fkummer/Electrical-and-Software/README.md

# Electrical-and-Software
Repository for the 2016-2017 Electrical and Software subteam of CRT

We're using the GitFlow Workflow! SO DON'T COMMIT TO MASTER!!!!! Make pull requests into develop.

Learn more about GitFlow here: https://www.atlassian.com/git/tutorials/comparing-workflows/gitflow-workflow
