fkummer/Electrical-and-Software/RCS/INTEVLoggerParts.txt

1. 3.3V Regulator http://www.mouser.com/ProductDetail/STMicroelectronics/LD1117S33TR/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
