fkummer/Electrical-and-Software/RCS/INTEVLogger Bill of Materials.xlsx

RCSMCU
Part Name | Value | Quantity | Datasheet | Supplier | Notes
Female micro-usb |  | 1 |  | https://www.sparkfun.com/products/8533
ATmega328p | ucontroller | 1 |  | http://www.digikey.com/product-detail/en/atmel/ATMEGA328P-AUR/ATMEGA328P-AURCT-ND/3789455
FT232RL | FTDI | 1 |  | http://www.digikey.com/product-detail/en/ftdi-future-technology-devices-international-ltd/FT232RL-REEL/768-1007-1-ND/1836402
Crystal | 8MHz | 1 |  | https://www.sparkfun.com/products/538
LED | GREEN | 1 |  | http://www.digikey.com/product-detail/en/kingbright/APTL3216CGCK/754-1162-1-ND/1747879
LED | YELLOW | 2 |  | http://www.digikey.com/product-detail/en/lite-on-inc/LTST-C150AKT/160-1166-1-ND/269238
LED | RED | 1 |  | http://www.digikey.com/product-detail/en/kingbright/APTL3216SURCK/754-1165-1-ND/1747882
Resistors | 10k | 3 |  | http://www.digikey.com/product-detail/en/yageo/RC1206JR-0710KL/311-10KERCT-ND/732156
Resistors | 100 | 4 |  | http://www.digikey.com/product-detail/en/yageo/RC1206FR-07100RL/311-100FRCT-ND/731438
Capacitors | 10uf | 1 |  | http://www.mouser.com/ProductDetail/Murata/GRM31CR61E106KA12K/?qs=giATsht9l5y2a9ASvPbnVA%3D%3D
Capacitors | 0.1uf | 6 |  | http://www.mouser.com/ProductDetail/AVX/12065C104KAT2A/?qs=WcAEtQi8OAaNkVk1OXh0eQ%3D%3D
Capacitors | 22pf | 2 |  | http://www.mouser.com/ProductDetail/Murata/GRM31A7U2J220JW31D/?qs=BT0JzrMzk1UKv3wBPModOw%3D%3D
MPU-9250 | IMU | 1 |  | http://www.digikey.com/product-detail/en/invensense/MPU-9250/1428-1019-1-ND/4626450?WT.srch=1
MPL3115a2 Altimeter | Altimeter | 1 |  | http://www.digikey.com/product-detail/en/nxp-usa-inc/MPL3115A2/MPL3115A2-ND/2817529
Micro SD connector |  | 1 |  | https://www.adafruit.com/products/1660?gclid=CKetvaHWx9ECFZCFswodQrwH7A
3.3V Regulator |  | 1 |  | http://www.mouser.com/ProductDetail/STMicroelectronics/LD1117S33TR/
SMD Switch |  | 1 |  | http://www.mouser.com/ProductDetail/ALPS/SKPMANE010/?qs=m0BA540hBPdOXU%252bNv5vyYw%3D%3D
Battery |  | 1 |  | https://www.adafruit.com/products/1578
JST Header | 2 port | 1 |  | https://www.adafruit.com/product/1769
SD Card | 16 GB | 1 |  | https://www.sparkfun.com/products/13833
