fkummer/Electrical-and-Software/Subscale/Schematics/documentation-sen0142/Layout.pdf

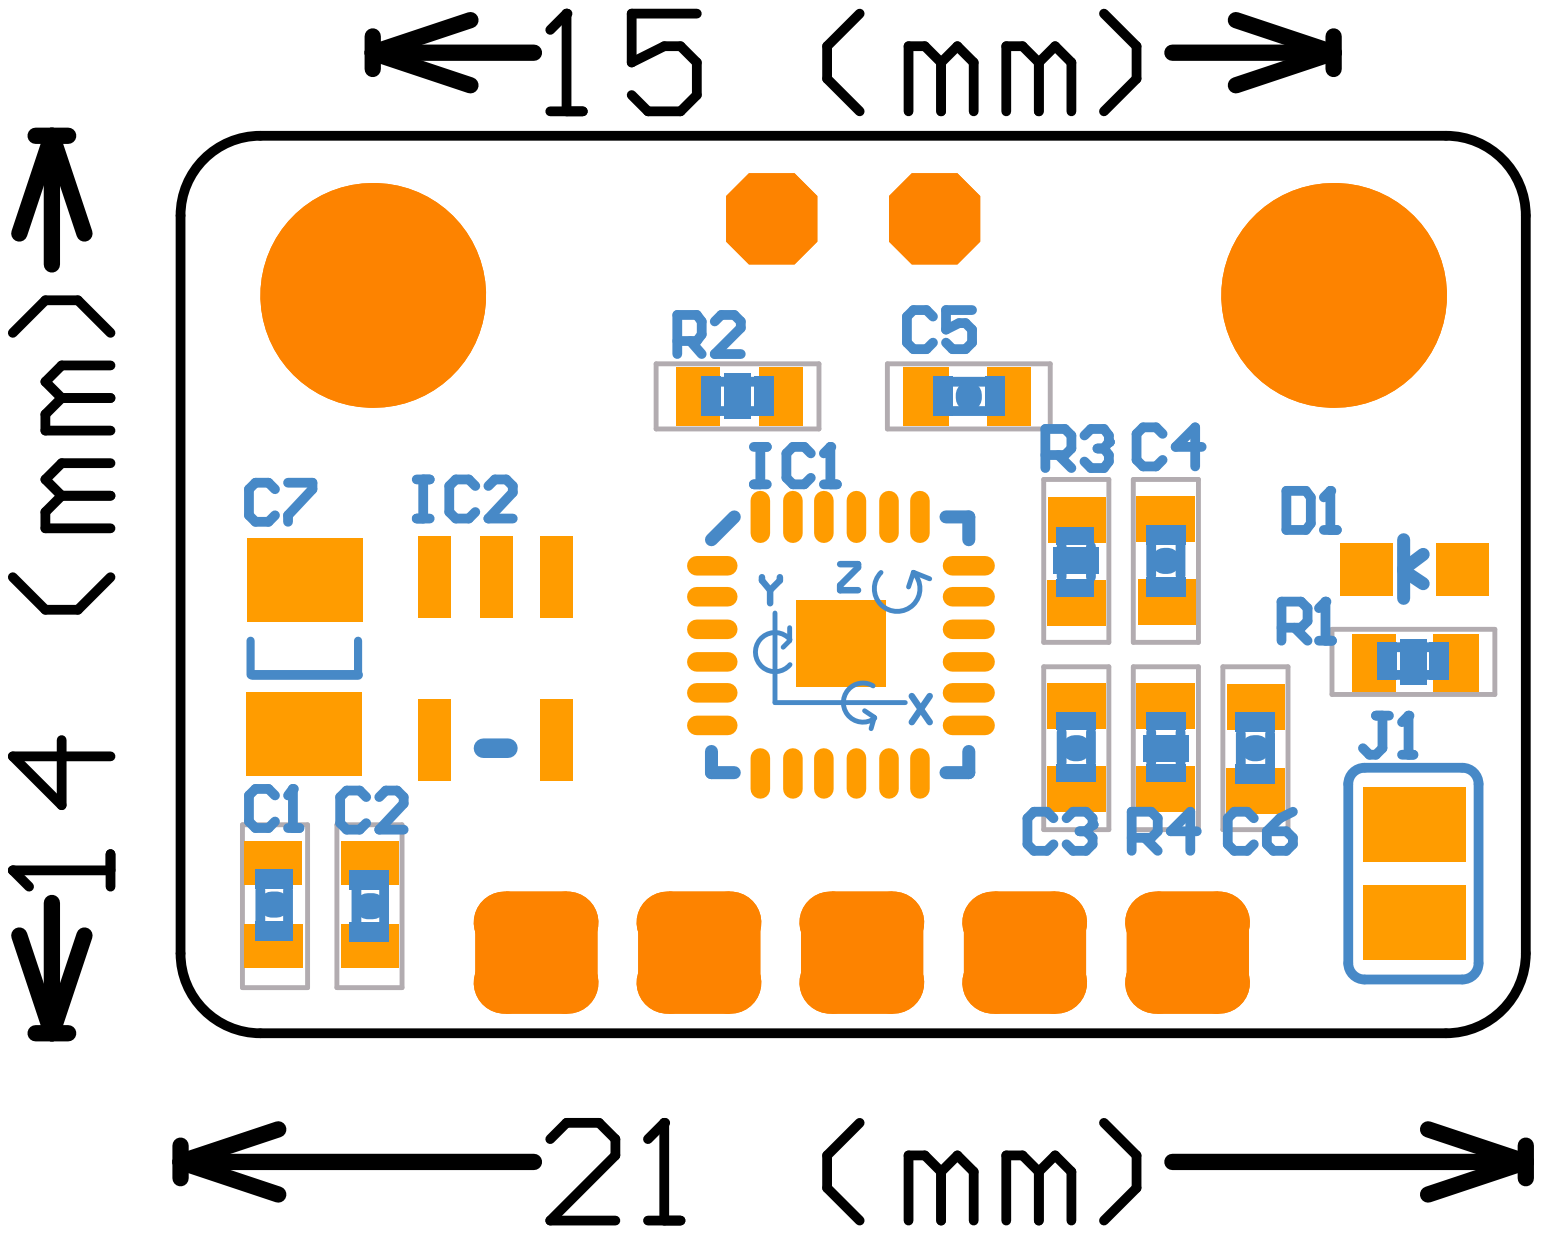
[picture p1: page 1]
