fkummer/Electrical-and-Software/Subscale/Schematics/documentation-sen0142/Schematic.pdf

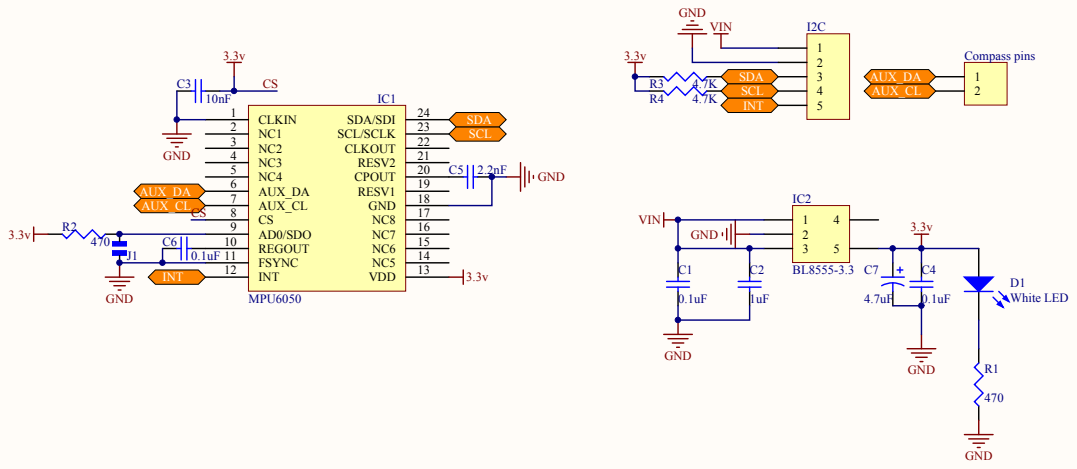
[picture p2: page 1]
