fkummer/Electrical-and-Software/doublesidedflasher.brd

## EAGLE design doublesidedflasher.brd (2017-04-30)

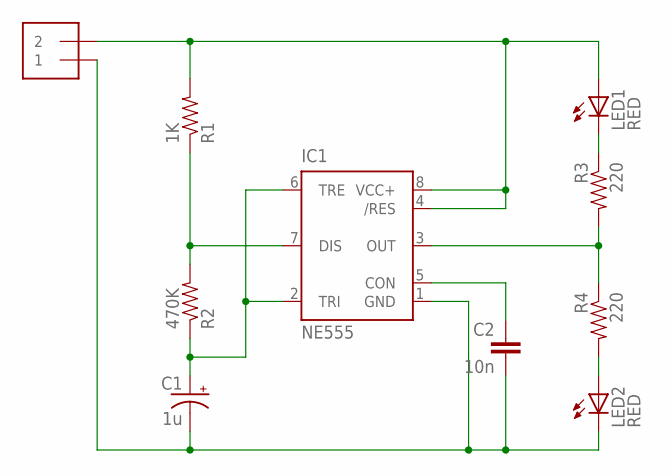
[picture p3: schematic doublesidedflasher.sch]

Parts:
C1: 1u; CPOL-RADIAL-10UF-25V
C2: 10n; CAP-PTH-SMALL
IC1: NE555; DIL-08
J1: 1X2-3.5MM
LED1, LED2: RED; LED5MM
R1: 1K; AXIAL-0.3
R2: 470K; AXIAL-0.3
R3, R4: 220; AXIAL-0.3

Connections:
GND: C1.2 (-), C2.2, IC1.1 (GND), J1.1, LED2.K (C)
unnamed: IC1.7 (DIS), R1.P$1 (1), R2.P$2 (2)
unnamed: LED2.A, R4.P$2 (2)
unnamed: LED1.K (C), R3.P$1 (1)
unnamed: IC1.3 (OUT), R3.P$2 (2), R4.P$1 (1)
unnamed: C1.1 (+), IC1.2 (TRI), IC1.6 (TRE), R2.P$1 (1)
unnamed: C2.1, IC1.5 (CON)
VCC+: IC1.4 (/RES), IC1.8 (VCC+), J1.2, LED1.A, R1.P$2 (2)

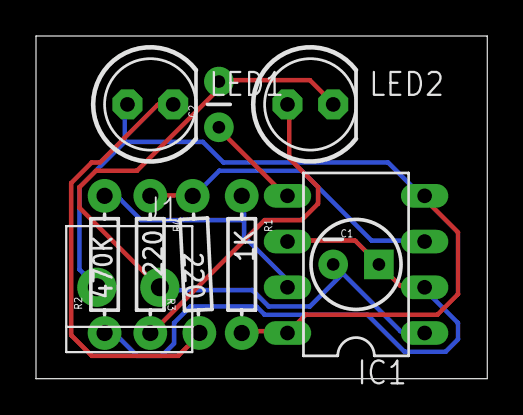
[picture p4: board doublesidedflasher.brd from above]

Board: 2 copper layers, 25.1 x 19.0 mm, 10 parts (0 on the bottom side), 8 nets.
