fkummer/Electrical-and-Software/RCS/MCU/Schematics/MCU_V4.brd

## EAGLE design RCS/MCU/Schematics/MCU_V4.brd (2017-01-18)

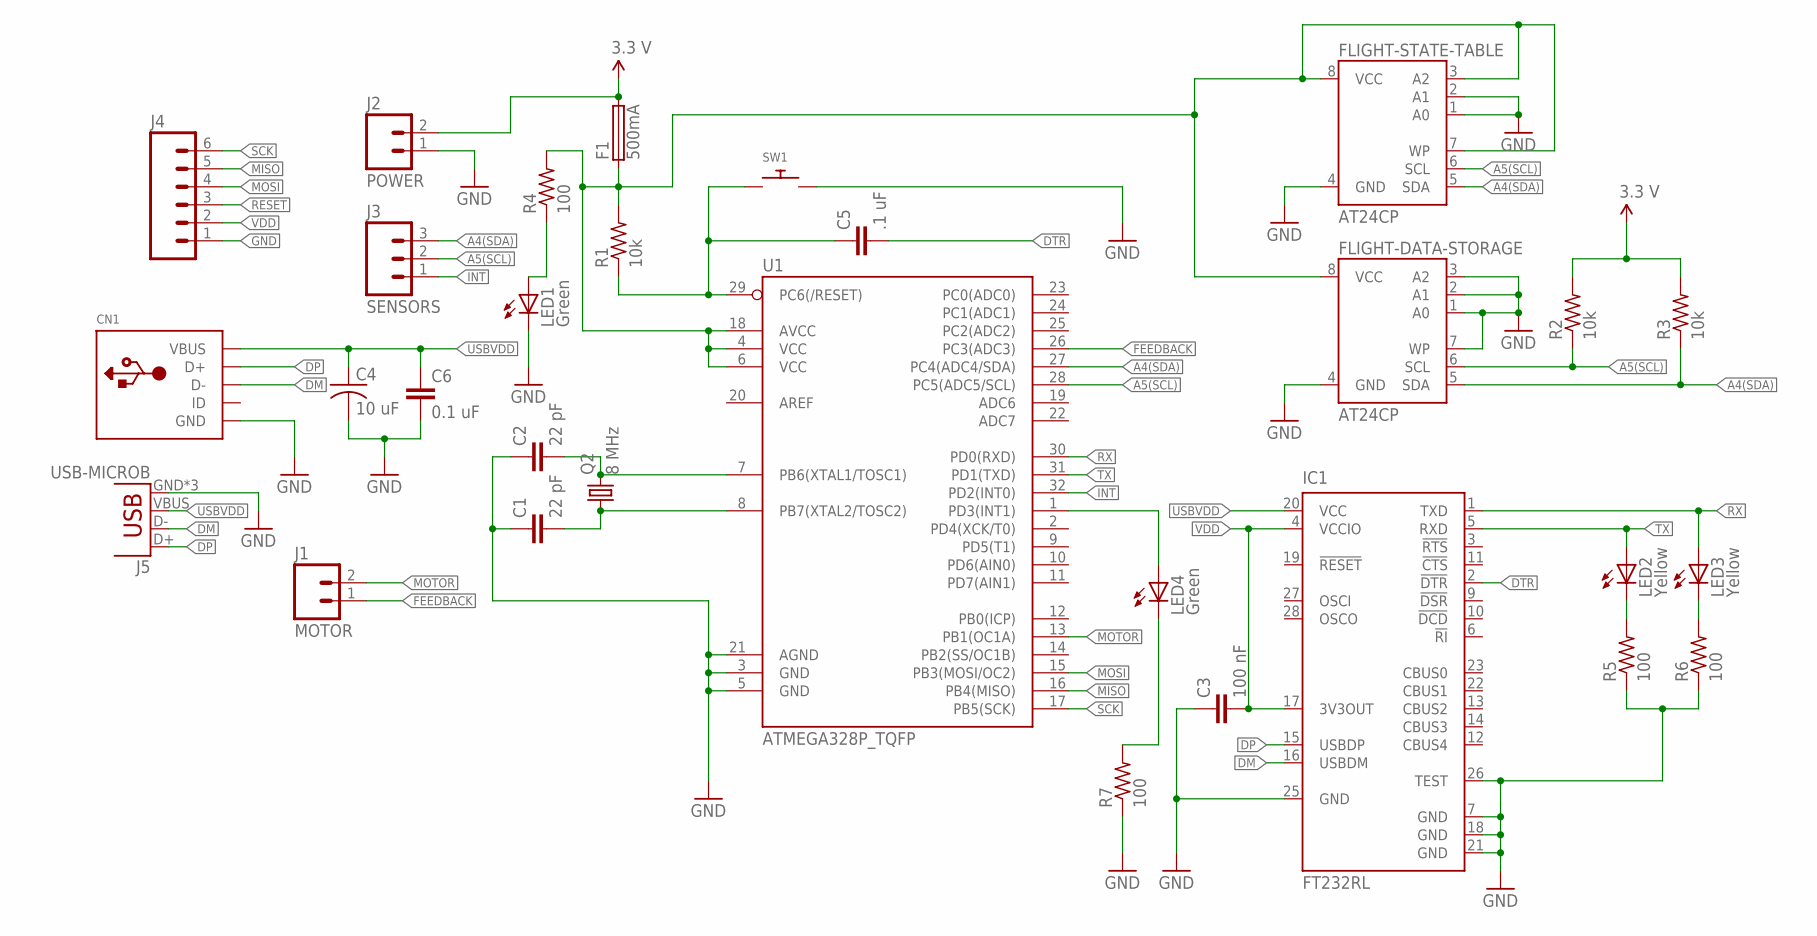
[picture p5: schematic MCU_V4.sch]

Parts:
C1, C2: 22 pF; C2.5-3
C3: 100 nF; C2.5-3
C4: 10 uF; C025-024X044
C5: .1 uF; C2.5-3
C6: 0.1 uF; C2.5-3
CN1: USBMOLEX; USB-MINIB-THM-MOLEX
F1: 500mA; PICOFUSE
FLIGHT-DATA-STORAGE: AT24CP; DIL08
FLIGHT-STATE-TABLE: AT24CP; DIL08
IC1: FT232RL; SSOP28
J1: MOTOR; 1X02_LOCK
J2: POWER; 1X02_LOCK
J3: SENSORS; 1X03_LOCK
J4: M06LOCK; 1X06_LOCK
J5: USB-MICROB
LED1, LED4: Green; CHIPLED_1206
LED2, LED3: Yellow; CHIPLED_1206
Q2: 8 MHz; HC49/S
R1, R2, R3: 10k; R1206
R4, R5, R6, R7: 100; R1206
SW1: SWITCH_PUSHBUTTONSOFTTOUCHSMD_SJ; PUSHBUTTON_SMD_SJ
U1: ATMEGA328P_TQFP; TQFP32-08

Connections:
A4(SDA): FLIGHT-DATA-STORAGE.5 (SDA), FLIGHT-STATE-TABLE.5 (SDA), J3.3, R3.1, U1.27 (PC4(ADC4/SDA))
A5(SCL): FLIGHT-DATA-STORAGE.6 (SCL), FLIGHT-STATE-TABLE.6 (SCL), J3.2, R2.1, U1.28 (PC5(ADC5/SCL))
DM: CN1.D-, IC1.16 (USBDM), J5.D-
DP: CN1.D+, IC1.15 (USBDP), J5.D+
DTR: C5.2, IC1.2 (!DTR)
FEEDBACK: J1.1, U1.26 (PC3(ADC3))
GND: C1.1, C2.1, C3.1, C4.2, C6.2, CN1.GND, FLIGHT-DATA-STORAGE.1 (A0), FLIGHT-DATA-STORAGE.2 (A1), FLIGHT-DATA-STORAGE.3 (A2), FLIGHT-DATA-STORAGE.4 (GND), FLIGHT-DATA-STORAGE.7 (WP), FLIGHT-STATE-TABLE.1 (A0), FLIGHT-STATE-TABLE.2 (A1), FLIGHT-STATE-TABLE.4 (GND), IC1.7 (GND), IC1.18 (GND), IC1.21 (GND), IC1.25 (GND), IC1.26 (TEST), J2.1, J4.1, J5.GND, J5.MT1 (GND), J5.MT2 (GND), LED1.C, R5.1, R6.1, R7.1, SW1.P$2, U1.3 (GND), U1.5 (GND), U1.21 (AGND)
INT: J3.1, U1.32 (PD2(INT0))
MISO: J4.5, U1.16 (PB4(MISO))
MOSI: J4.4, U1.15 (PB3(MOSI/OC2))
MOTOR: J1.2, U1.13 (PB1(OC1A))
unnamed: F1.1, FLIGHT-DATA-STORAGE.8 (VCC), FLIGHT-STATE-TABLE.3 (A2), FLIGHT-STATE-TABLE.7 (WP), FLIGHT-STATE-TABLE.8 (VCC), R1.2, R4.2, U1.4 (VCC), U1.6 (VCC), U1.18 (AVCC)
unnamed: C2.2, Q2.2, U1.7 (PB6(XTAL1/TOSC1))
unnamed: C1.2, Q2.1, U1.8 (PB7(XTAL2/TOSC2))
unnamed: LED4.A, U1.1 (PD3(INT1))
unnamed: LED1.A, R4.1
unnamed: LED4.C, R7.2
unnamed: LED2.C, R5.2
unnamed: LED3.C, R6.2
RESET: C5.1, J4.3, R1.1, SW1.P$1, U1.29 (PC6(/RESET))
RX: IC1.1 (TXD), LED3.A, U1.30 (PD0(RXD))
SCK: J4.6, U1.17 (PB5(SCK))
TX: IC1.5 (RXD), LED2.A, U1.31 (PD1(TXD))
USBVDD: C4.1, C6.1, CN1.VBUS, IC1.20 (VCC), J5.VBUS
VDD: C3.2, F1.2, IC1.4 (VCCIO), IC1.17 (3V3OUT), J2.2, J4.2, R2.2, R3.2

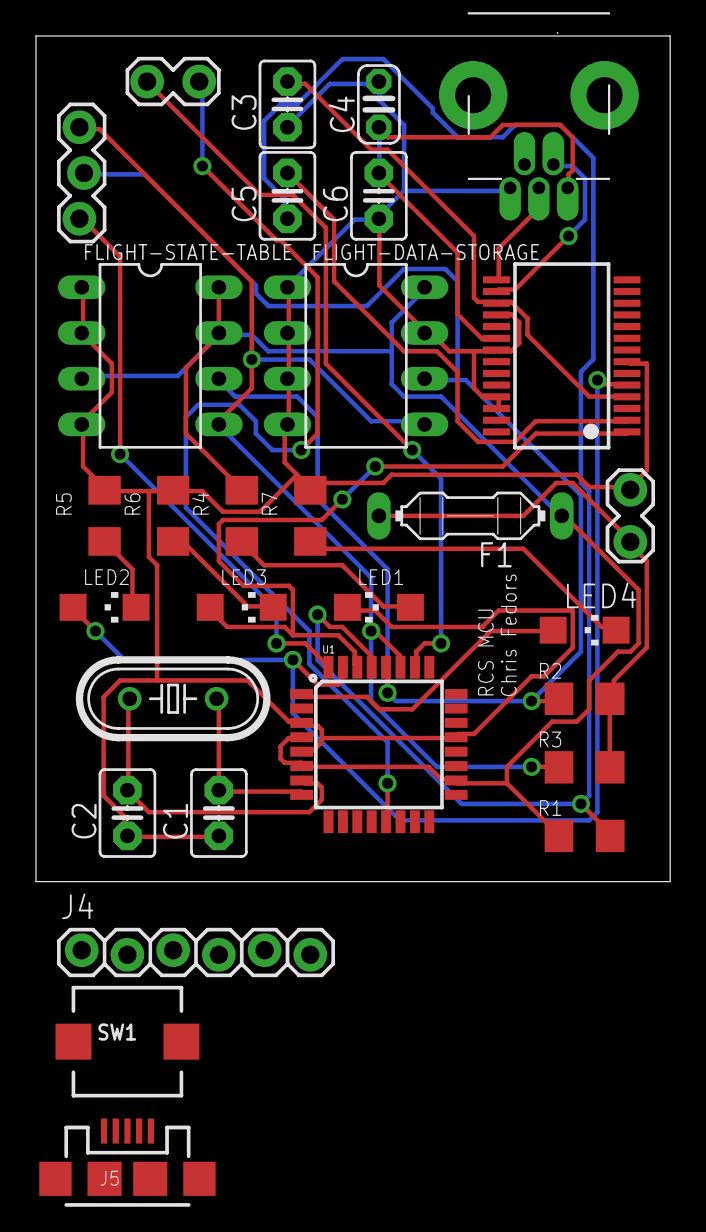
[picture p6: board MCU_V4.brd from above]

Board: 2 copper layers, 35.2 x 47.0 mm, 30 parts (0 on the bottom side), 25 nets.
