fkummer/Electrical-and-Software/RCS/INTEVLogger2.brd

## EAGLE design RCS/INTEVLogger2.brd (2017-01-18)

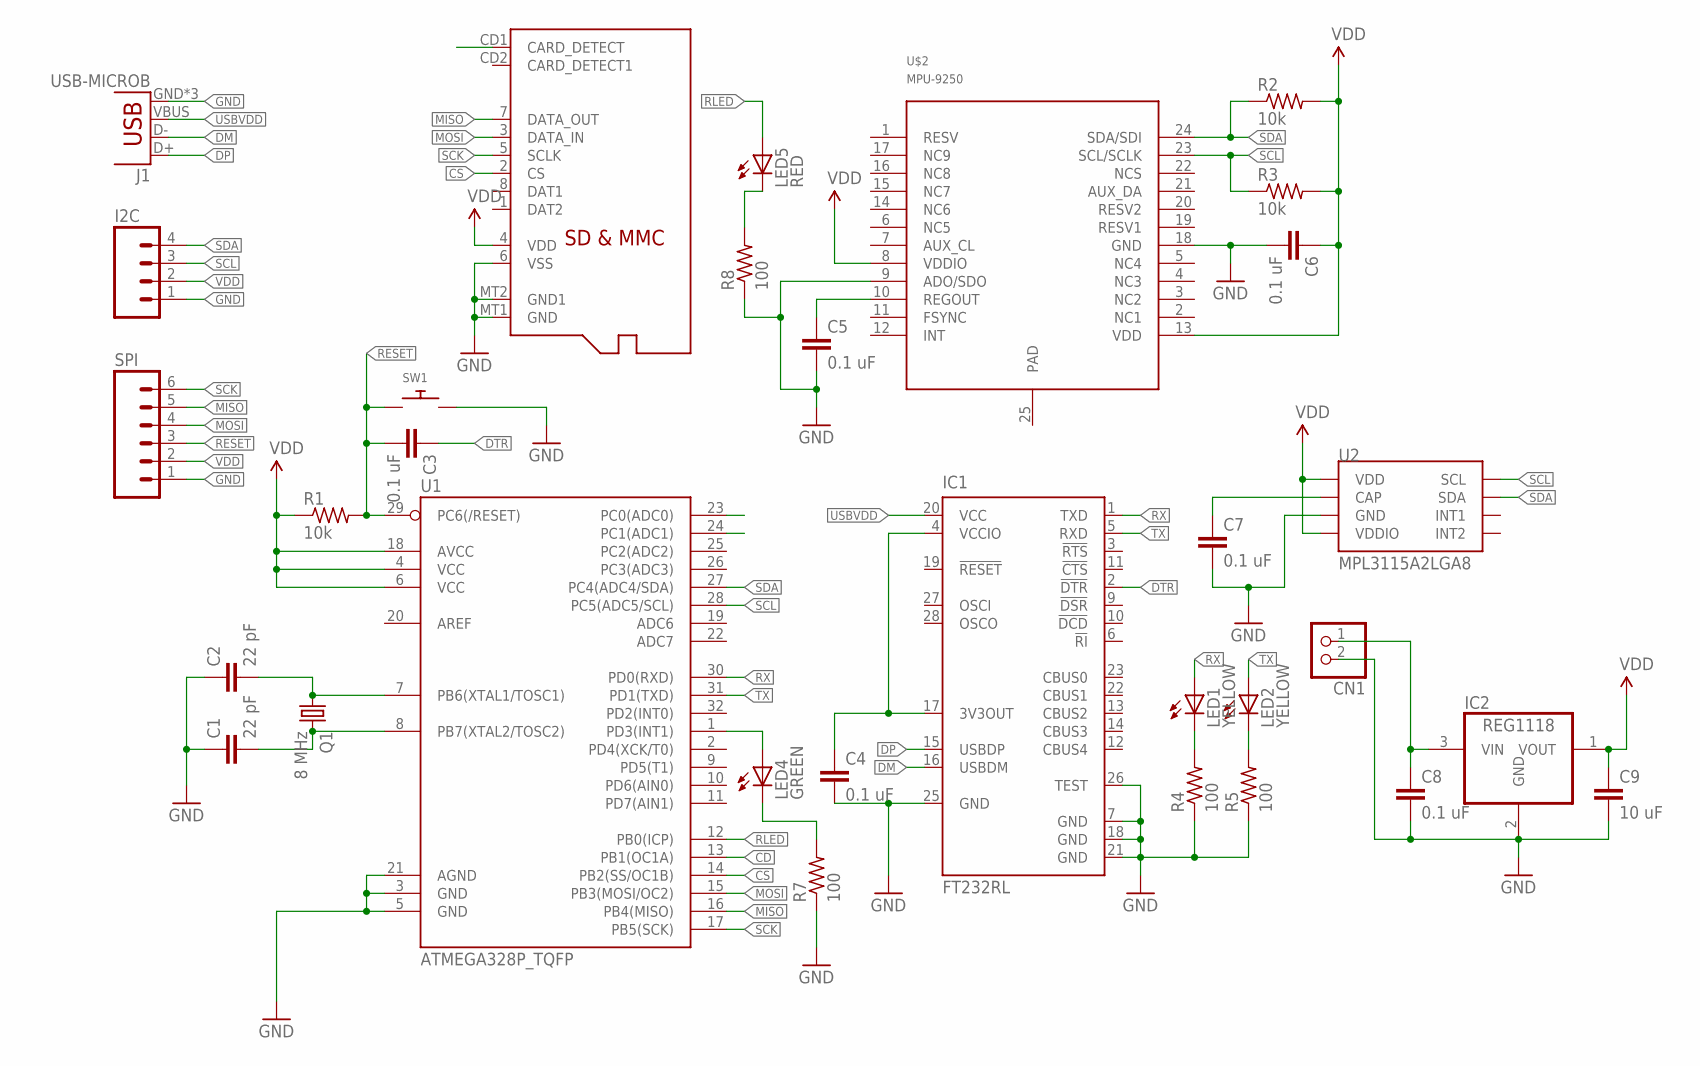
[picture p7: schematic INTEVLogger2.sch]

Parts:
C1, C2: 22 pF; 1206
C3, C4, C5, C6, C7, C8: 0.1 uF; 1206
C9: 10 uF; 1206
CN1: JST_2PIN-SMT; JST-PH-2-SMT
I2C: M04PTH; 1X04
IC1: FT232RL; SSOP28
IC2: REG1118; SOT223
J1: USB-MICROB
LED1, LED2: YELLOW; CHIPLED_1206
LED4: GREEN; CHIPLED_1206
LED5: RED; CHIPLED_1206
Q1: 8 MHz; HC49/S
R1, R2, R3: 10k; M1206
R4, R5, R7, R8: 100; M1206
SPI: M06LOCK; 1X06_LOCK
SW1: SWITCH_PUSHBUTTONSOFTTOUCHSMD_SJ; PUSHBUTTON_SMD_SJ
U1: ATMEGA328P_TQFP; TQFP32-08
U2: MPL3115A2LGA8; LGA8
U$1: MICROSD
U$2: MPU-9250; LEAD-QFN24

Connections:
CD: U1.13 (PB1(OC1A)), U$1.CD1 (CARD_DETECT)
CS: U1.14 (PB2(SS/OC1B)), U$1.2 (CS)
DM: IC1.16 (USBDM), J1.D-
DP: IC1.15 (USBDP), J1.D+
DTR: C3.1, IC1.2 (!DTR)
GND: C1.1, C2.1, C4.2, C5.2, C6.2, C7.2, C8.2, C9.2, CN1.2 (1), I2C.1, IC1.7 (GND), IC1.18 (GND), IC1.21 (GND), IC1.25 (GND), IC1.26 (TEST), IC2.2 (GND), J1.GND, J1.MT1 (GND), J1.MT2 (GND), R4.1, R5.1, R7.1, R8.1, SPI.1, SW1.P$2, U1.3 (GND), U1.5 (GND), U1.21 (AGND), U2.3 (GND), U$1.6 (VSS), U$1.MT1 (GND), U$1.MT2 (GND1), U$2.9 (ADO/SDO), U$2.18 (GND)
MISO: SPI.5, U1.16 (PB4(MISO)), U$1.7 (DATA_OUT)
MOSI: SPI.4, U1.15 (PB3(MOSI/OC2)), U$1.3 (DATA_IN)
unnamed: C1.2, Q1.2, U1.8 (PB7(XTAL2/TOSC2))
unnamed: C2.2, Q1.1, U1.7 (PB6(XTAL1/TOSC1))
unnamed: C5.1, U$2.10 (REGOUT)
unnamed: LED4.A, U1.1 (PD3(INT1))
unnamed: C8.1, CN1.1 (2), IC2.3 (VIN)
unnamed: C4.1, IC1.4 (VCCIO), IC1.17 (3V3OUT)
unnamed: C7.1, U2.2 (CAP)
unnamed: LED4.C, R7.2
unnamed: LED1.C, R4.2
unnamed: LED2.C, R5.2
unnamed: LED5.C, R8.2
RESET: C3.2, R1.2, SPI.3, SW1.P$1, U1.29 (PC6(/RESET))
RLED: LED5.A, U1.12 (PB0(ICP))
RX: IC1.1 (TXD), LED1.A, U1.30 (PD0(RXD))
SCK: SPI.6, U1.17 (PB5(SCK)), U$1.5 (SCLK)
SCL: I2C.3, R3.1, U1.28 (PC5(ADC5/SCL)), U2.8 (SCL), U$2.23 (SCL/SCLK)
SDA: I2C.4, R2.1, U1.27 (PC4(ADC4/SDA)), U2.7 (SDA), U$2.24 (SDA/SDI)
TX: IC1.5 (RXD), LED2.A, U1.31 (PD1(TXD))
USBVDD: IC1.20 (VCC), J1.VBUS
VDD: C6.1, C9.1, I2C.2, IC2.1 (VOUT), R1.1, R2.2, R3.2, SPI.2, U1.4 (VCC), U1.6 (VCC), U1.18 (AVCC), U2.1 (VDD), U2.4 (VDDIO), U$1.4 (VDD), U$2.8 (VDDIO), U$2.13 (VDD)

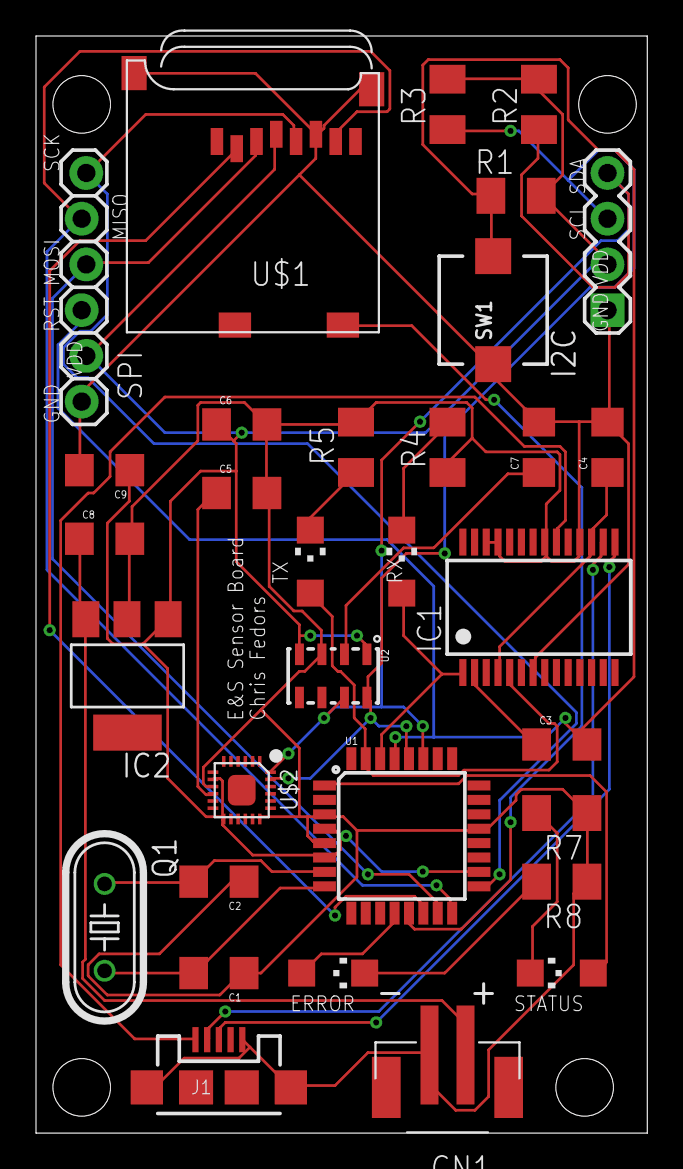
[picture p8: board INTEVLogger2.brd from above]

Board: 2 copper layers, 34.0 x 61.0 mm, 32 parts (0 on the bottom side), 28 nets.
