fkummer/Electrical-and-Software/RCS/MCU/Code/RCSMCUV1/GccApplication1/main.c

/*
 * RCSMCUV1.c
 *
 * Created: 11/6/2016 2:39:24 PM
 * Author : Chris Fedors
 */ 

#include <avr/io.h>
#include <util/delay.h>

#define F_CPU 8000000UL //Clock speed of 8MHz

//Macros for pins to be used


int main(void)
{
    /* Replace with your application code */
    while (1) 
    {
		
    }
}
