fkummer/Electrical-and-Software/RCS/MCU/Code/RCS_MCU_IDE/RCS_MCU_IDE.ino

/* Chris Fedors
This code is intended to test the control system for the RCS MCU module.
*/

#include "wire.h"

#define LED 3 //Debug LED is on pin 3

int getAngle(){
  /*Returns the angle of the fin's deflection*/
}

void moveToAngle(){
  /*Acuates the fins to a given angle*/
}

int getRollRate(){
  /*Returns the current roll rate of the rocket*/
}

int getAltitude(){
  /*Returns the altitude of the rocket*/
}

int getVericalVelocity(){
  /*Retruns the rocket's current vertical velocity*/
}

int getVerticalAccl(){
  /*Returns the rocket's current vertical velocity*/
}

int detectLaunch(){
  /*Returns 1 when launch is deteceted*/
}

void rollRocket(int rev){
  /*Rolls the rocket for rev revolutions*/
}

void stabalizeRocket(){
  /*Stabalizes the rocket about the roll axis*/
}



void setup() {
  // put your setup code here, to run once:

}

void loop() {
  // put your main code here, to run repeatedly:

}
