fkummer/Electrical-and-Software/(commit log)

2016-10-02 Repaired original design
    [Better Flasher.sch]
2016-10-13 laasya's training project
    sorry this is so late :(
    [timer.sch]
2016-10-16 updated training project
    thanks
    [timer.sch]
2016-10-16 Additional modifications to repaired design
    Changes were made based on comments
    [Better Flasher.sch]
2016-10-19 Schematic for sensor test rig
    First rev of sensor test rig, uses sparkfun breakout board and EEPROM
    [SensorTestRig_V1.sch]
2016-10-19 Cleaning up directory
    [SensorTestRig_V1.sch]
2016-10-19 Added basic schematic and tenative parts list
    [MCU_V1.sch]
2016-11-04 Updated Schematic
2016-11-04 Moved updated schematic to folder
    [MCU_V2.sch]
2016-11-08 Updated V3 Schematic
    [MCU_V3.sch]
2016-11-08 Added Resistors in series with LEDs
    [MCU_V3.sch, MCU_V4.sch]
2016-11-16 Deleted MCU_V4, since it was not the most recent update
    [MCU_V4.sch]
2016-11-18 Added GPIO LED and Capacitors on USB line
    [MCU_V3.sch]
2016-11-18 Started working on PCB
    [MCU_V3.brd, MCU_V3.sch]
2016-11-30 Completed PCB layout
    [MCU_V3.brd, MCU_V3.sch]
2017-01-13 Slightly updated schematic
    [MCU_V3.brd, MCU_V3.sch]
2017-01-14 Updated schematic and Started Coding
    Added SPI support on schematic
    [MCU_V4.brd, MCU_V4.sch]
2017-01-16 Updated INTEV Schematic
    [INTEV.sch, INTEVLogger.sch, MCU_V4.sch]
2017-01-18 More INTEV board updates
    [INTEVLogger Bill of Materials.xlsx, INTEVLogger2.brd, INTEVLogger2.sch]
2017-04-30 flasher with components on 2 sides
    [doublesidedflasher.sch]
